alekstubic-beep/Autonomous-Obstacle-Avoiding-Robot/hardware/Primjenjena_II.pdf

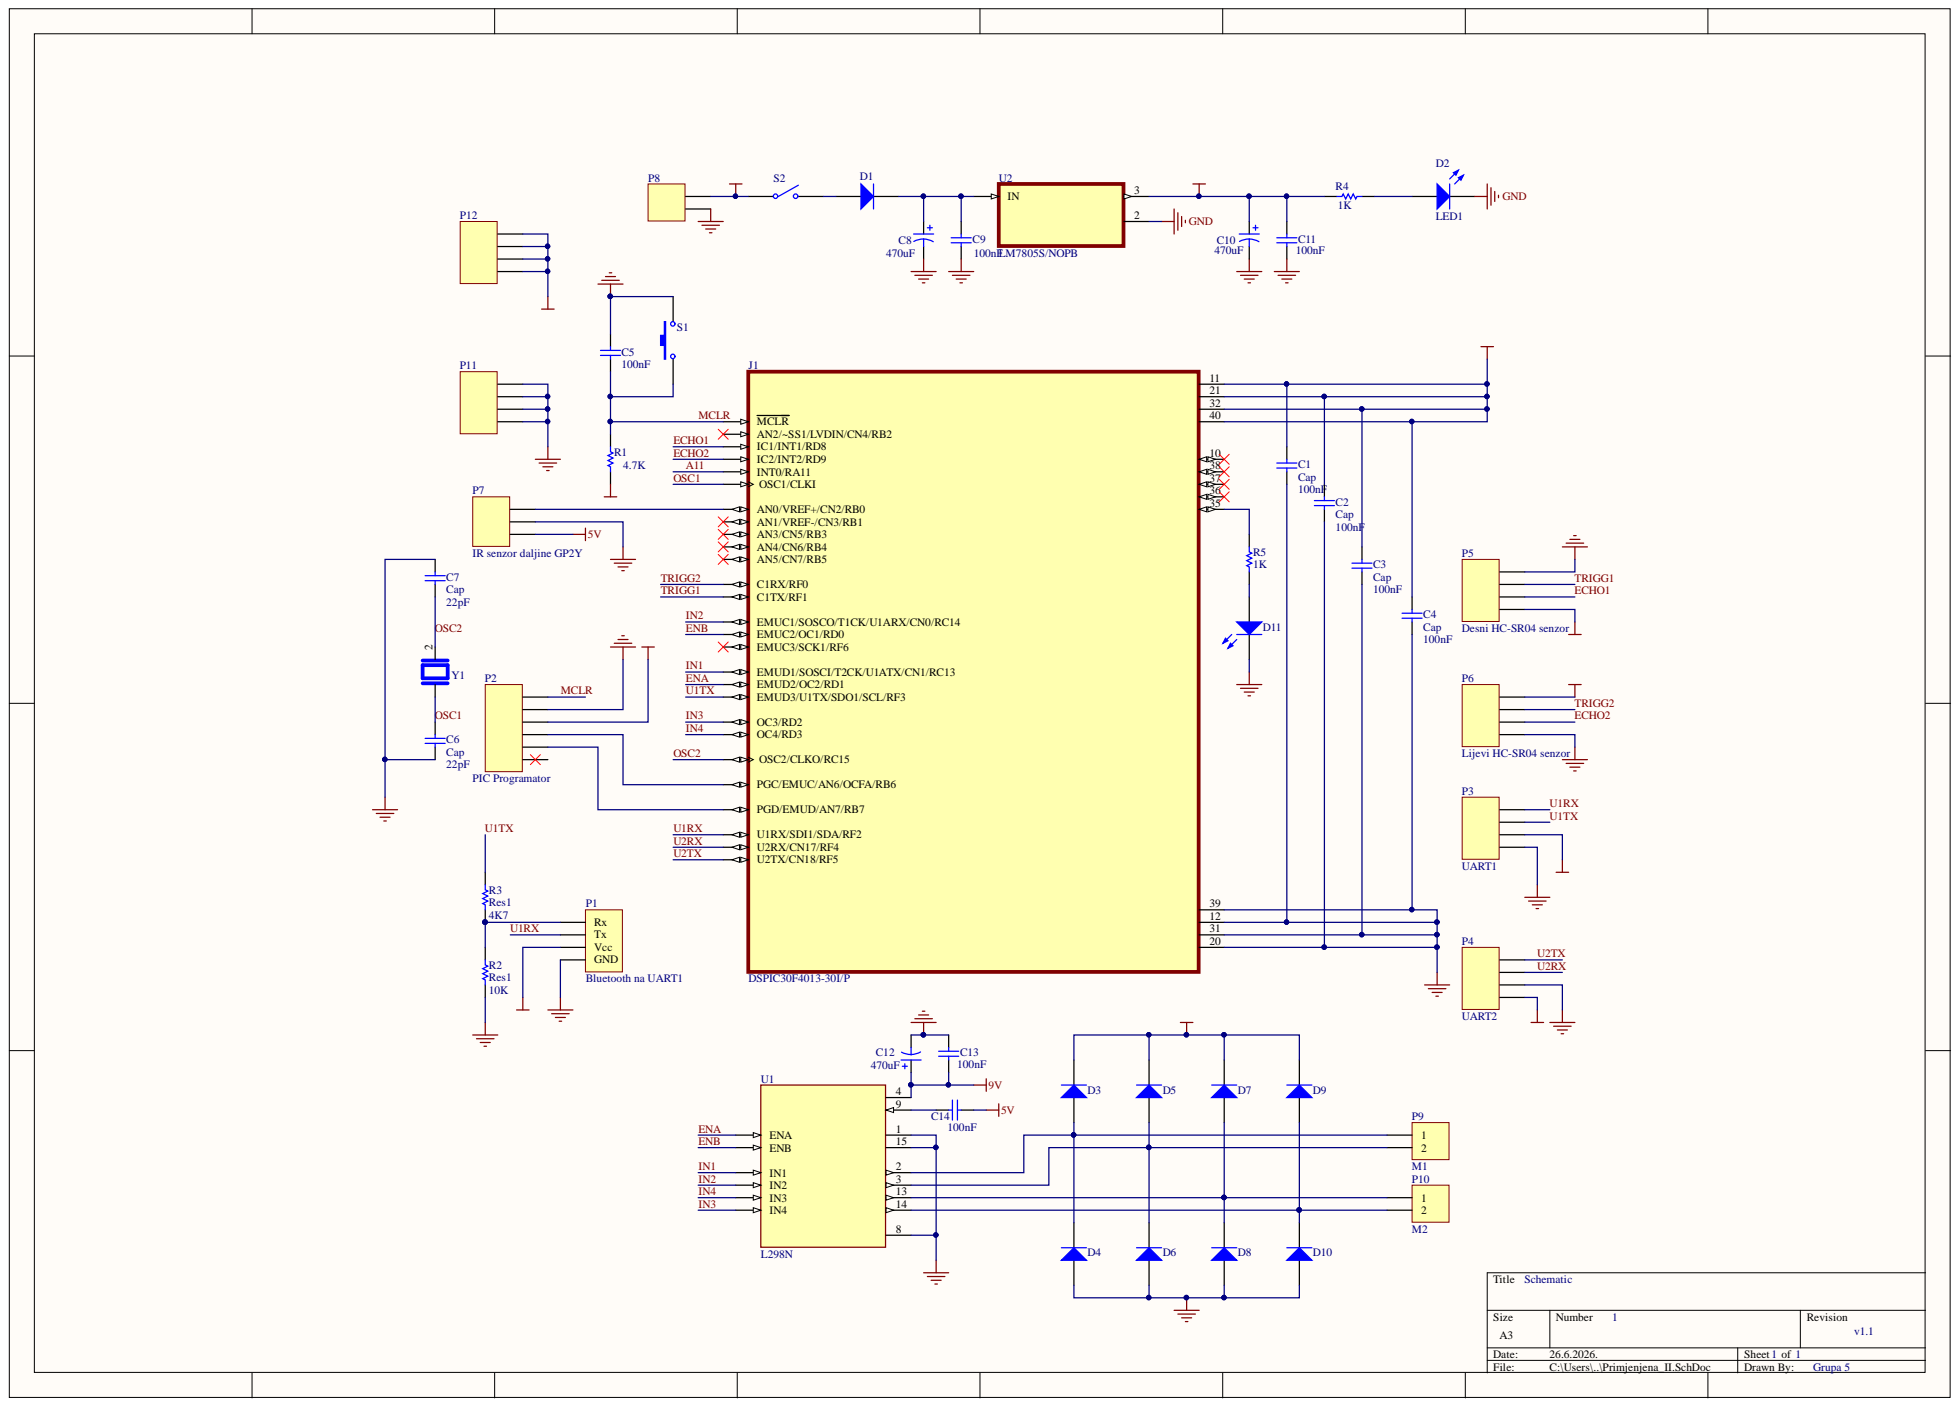
[picture p1: page 1]

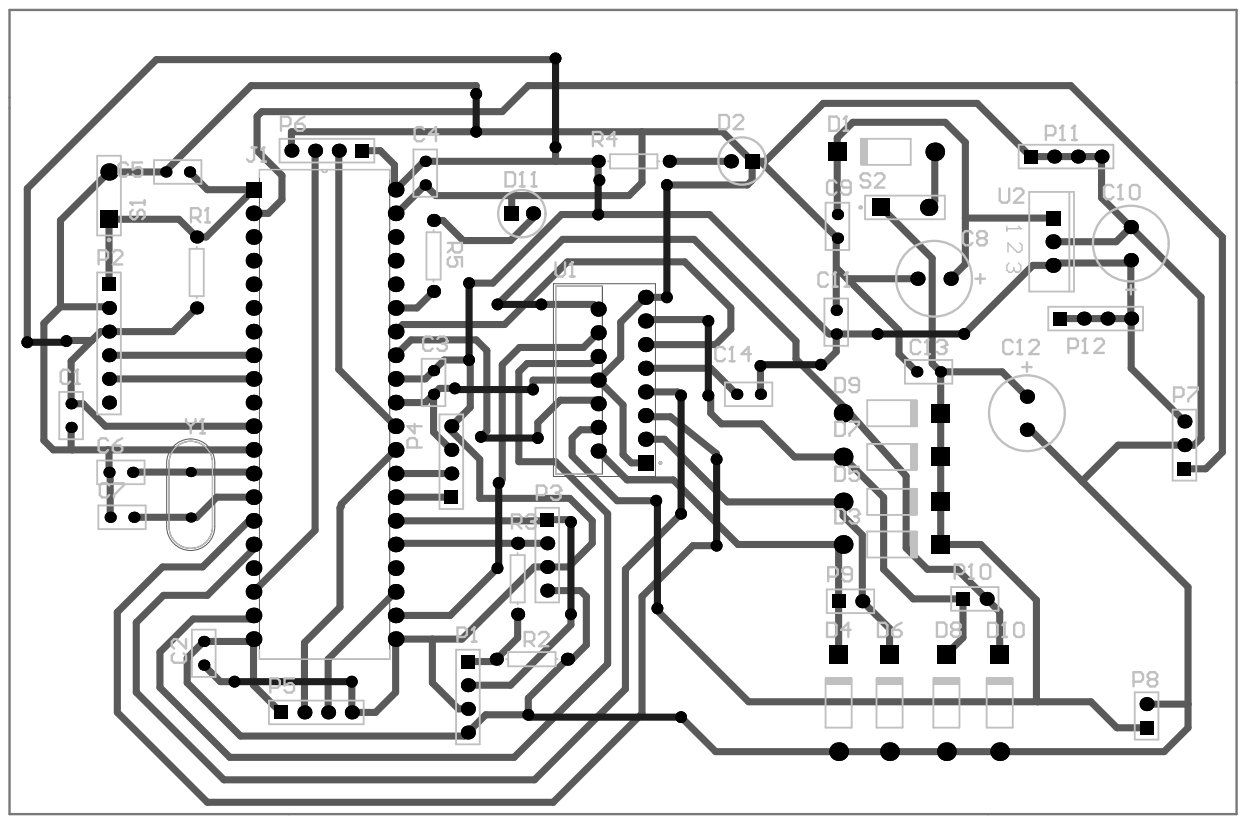
[picture p2: page 2]
