alekstubic-beep/Autonomous-Obstacle-Avoiding-Robot/(list of files, drawings)

Other design files:
hardware/Diode.PcbLib
hardware/DIP254P1524X482-40.PcbLib
hardware/Elektrolitski_kondenzator.PcbLib
hardware/HC-49_U-S16000000ABJB/HC-49_U-S16000000ABJB.SchLib
hardware/HC-49_U-S16000000ABJB/XTAL_HC49P488W43L1150T466H350.PcbLib
hardware/L298N/L298N.SchLib
hardware/L298N/TO127P2020X500X2100-15.PcbLib
hardware/Primjenjena_II.PrjPcb
hardware/Primjenjena_II.SchDoc
hardware/Projekat.PcbDoc
