alekstubic-beep/Autonomous-Obstacle-Avoiding-Robot/(commit log)

2026-06-26 Add hardware schematic and PCB project files
    [Primjenjena_II.PrjPcb, Primjenjena_II.SchDoc]
2026-06-26 Add hardware files
    [DIP254P1524X482-40.PcbLib, Diode.PcbLib, Elektrolitski_kondenzator.PcbLib, HC-49_U-S16000000ABJB.SchLib, L298N.SchLib, Projekat.PcbDoc, TO127P2020X500X2100-15.PcbLib, XTAL_HC49P488W43L1150T466H350.PcbLib]
